SJohnston95/ece411-practicum-1/eagle/411_Layout.PNG

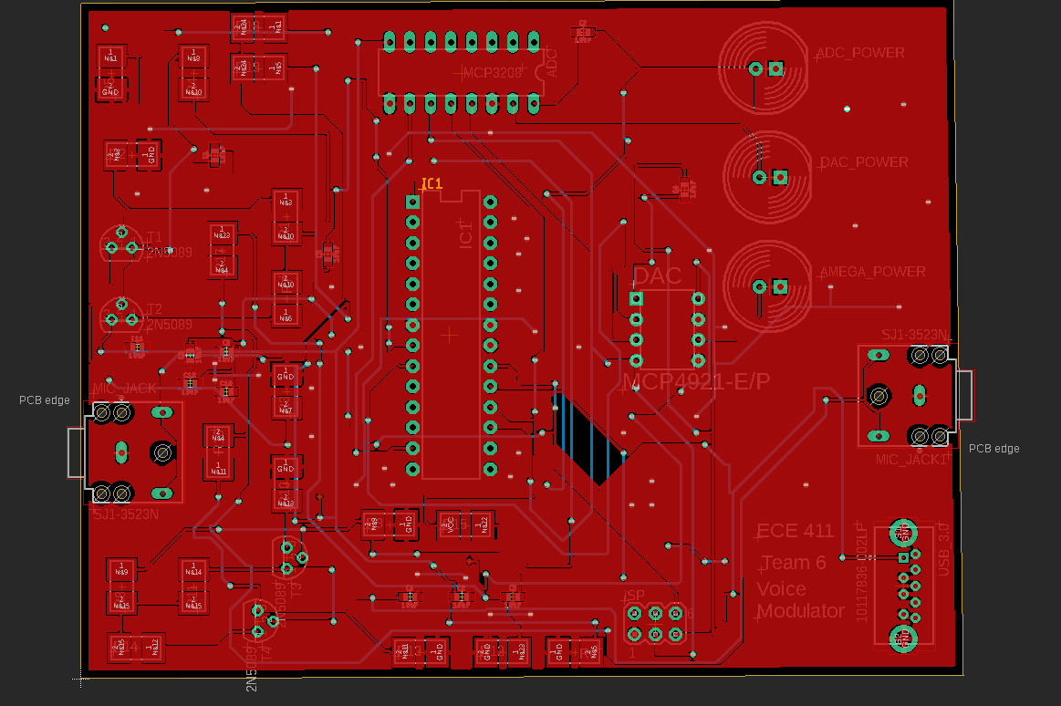
eagle/411_Layout.PNG
