SJohnston95/ece411-practicum-1/eagle/voicemodulator.PNG

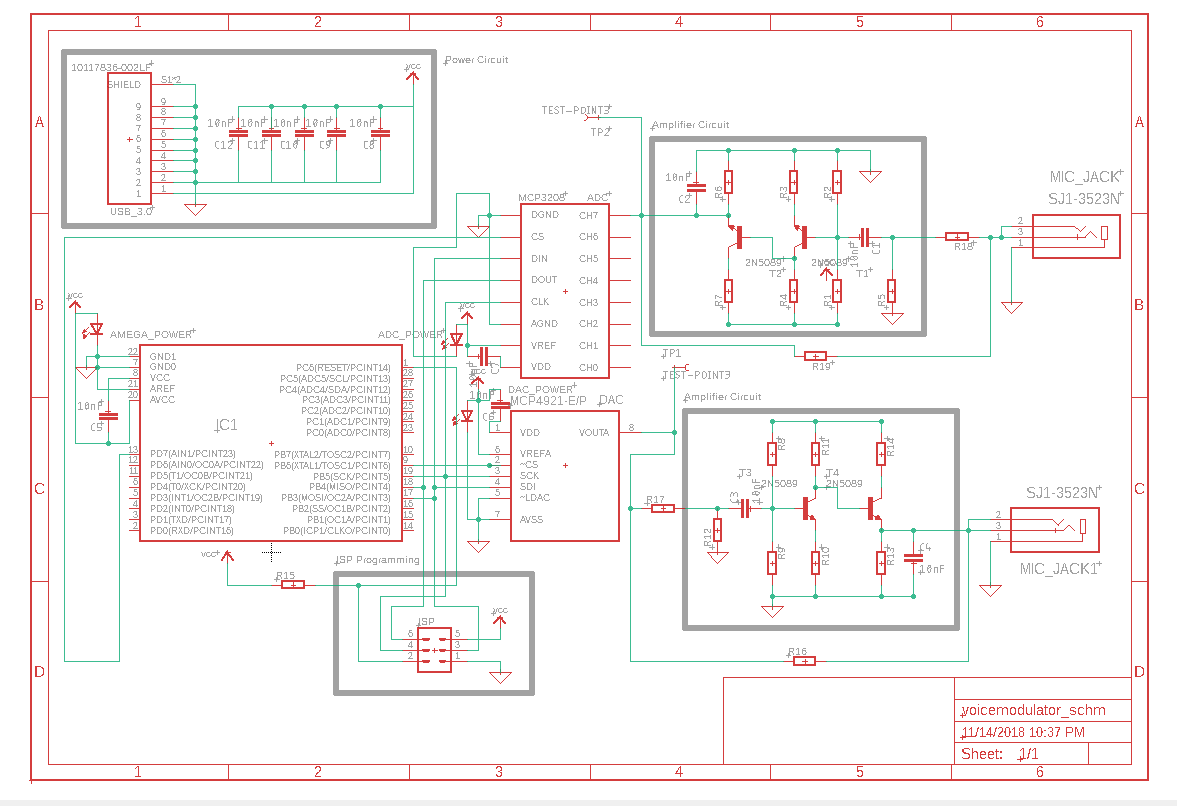
eagle/voicemodulator.PNG
