SJohnston95/ece411-practicum-1/waveforms/ECE411_bigendianbus.png

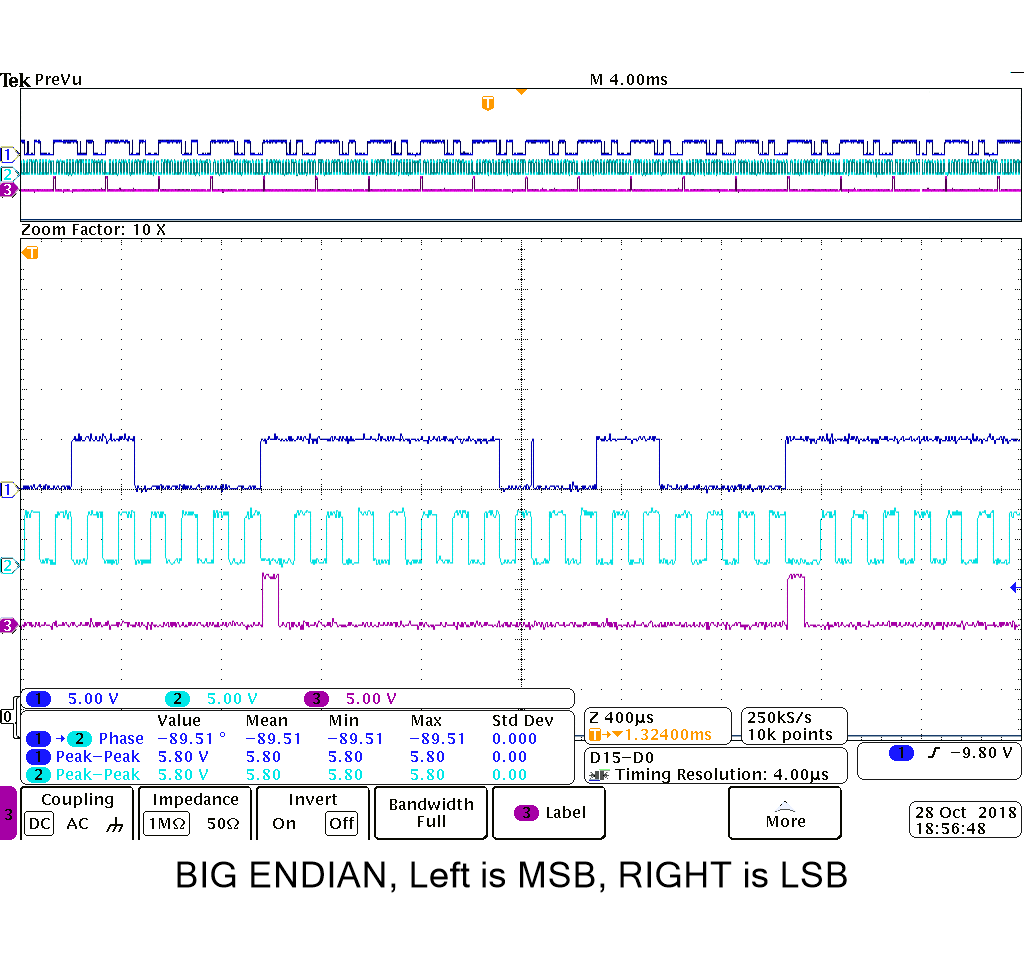
waveforms/ECE411_bigendianbus.png
