SJohnston95/ece411-practicum-1/waveforms/ECE411_littleendianbus.png

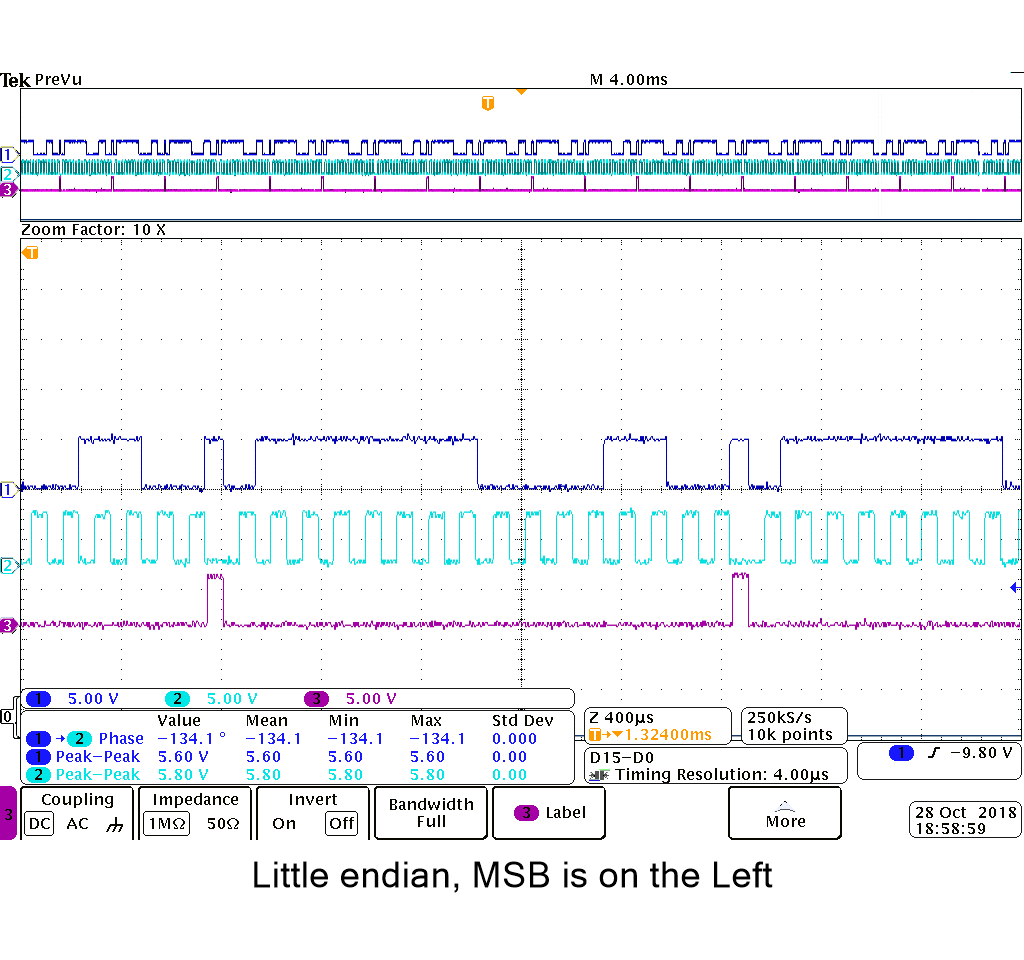
waveforms/ECE411_littleendianbus.png
