SJohnston95/ece411-practicum-1/waveforms/WorkingDAC_BUS.png

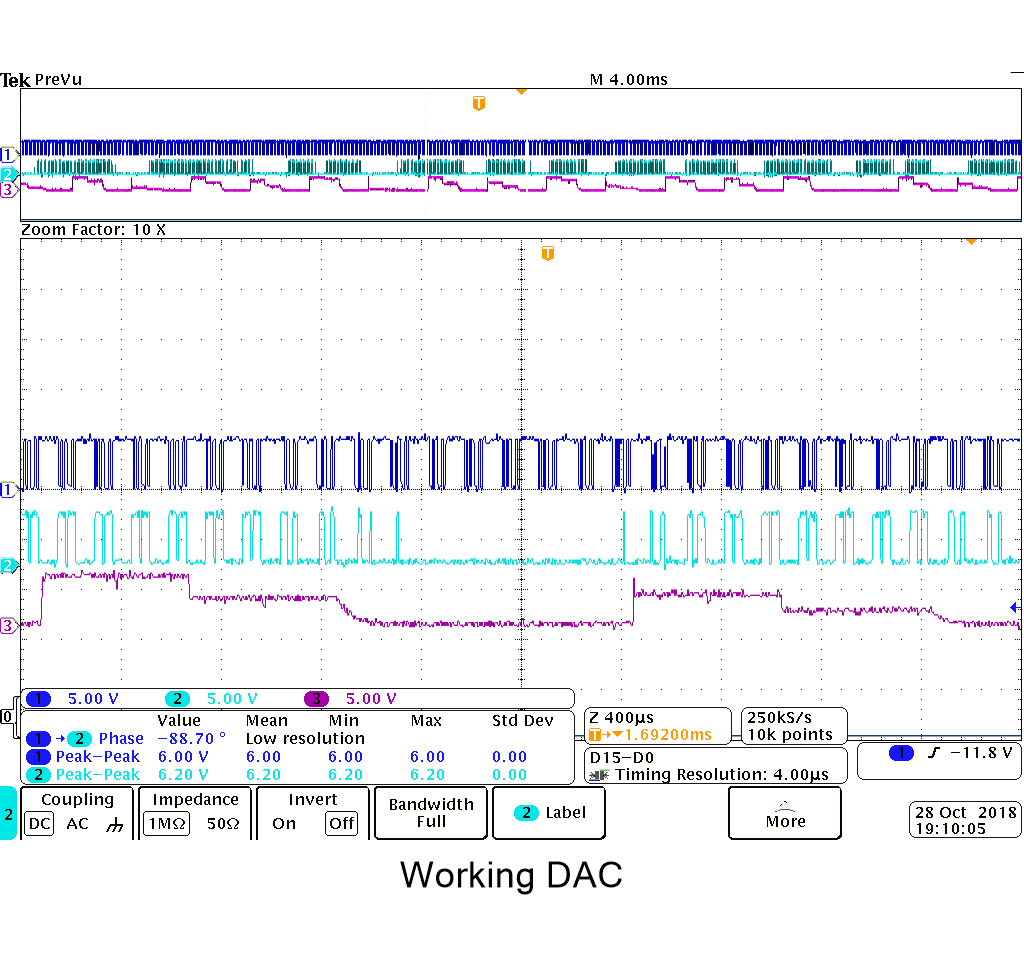
waveforms/WorkingDAC_BUS.png
