SJohnston95/ece411-practicum-1/docs/Bill of Materials.xlsx

Qty | Value | Device | Package | Parts | Description | AVAILABILITY | DESCRIPTION | MANUFACTURER | MF | MP | MPN | OC_FARNELL | OC_NEWARK | PACKAGE | PARTREV | PRICE | PROD_ID | STANDARD | SUPPLIER | VALUE
1 |  | ATMEGA48/88/168/328-PU(DIP28)PU | DIL28 | IC1
3 |  | LED10MM | LED10MM | LED1, LED2, LED3 | LED
1 |  | MA03-2 | MA03-2 | ISP | PIN HEADER |  |  |  |  |  |  | unknown | unknown
19 |  | SMR-WAV | SMS-WAV | R1, R2, R3, R4, R5, R6, R7, R8, R9, R10, R11, R12, R13, R14, R15, R16, R17, R18, R19 | SMD SHUNT RESISTOR |  |  |  |  |  |  | unknown | unknown
1 | 10117836-002LF | 10117836-002LF | AMPHENOL_10117836-002LF | USB_3.0 | Usb, 3.0 Type A, Receptacle, SMT | Unavailable | Usb, 3.0 Type A, Receptacle, SMT |  | Amphenol FCI | 10117836-002LF |  |  |  | None |  | None
4 | 10nF | 10NF-0603-50V-10% | 603 | C1, C2, C3, C4 | 0.01uF/10nF/10,000pF ceramic capacitors |  |  |  |  |  |  |  |  |  |  |  | CAP-00867 |  |  | 10nF
4 | 2N5089 | 2N5089 | TO92 | T1, T2, T3, T4 | NPN TRANSISTOR
1 | MCP3208 | MCP3208 | DIL16 | ADC |  |  |  |  |  |  |  |  |  |  |  |  |  |  |  | MCP3208
1 | MCP4921-E/P | MCP4921-E/P | DIP254P762X432-8 | DAC | DAC |  |  |  |  |  | MCP4921-E/P | 1332112 | 08J8743 | DIP-8 |  |  |  |  | Microchip
2 | SJ1-3523N | SJ1-3523N | CUI_SJ1-3523N | MIC_JACK, MIC_JACK1 | 3.5 mm Right-Angle Stereo Jack, 3 Pin PCB Mount, Non-Threaded |  |  | CUI |  |  |  |  |  |  | 1.02 |  |  | Manufacturer recommendation
2 | TEST-POINT3 | TEST-POINT3 | PAD.03X.03 | TP1, TP2 | SparkFun Test Points
