SJohnston95/ece411-practicum-1/docs/Matrix, Block Diagram.pdf

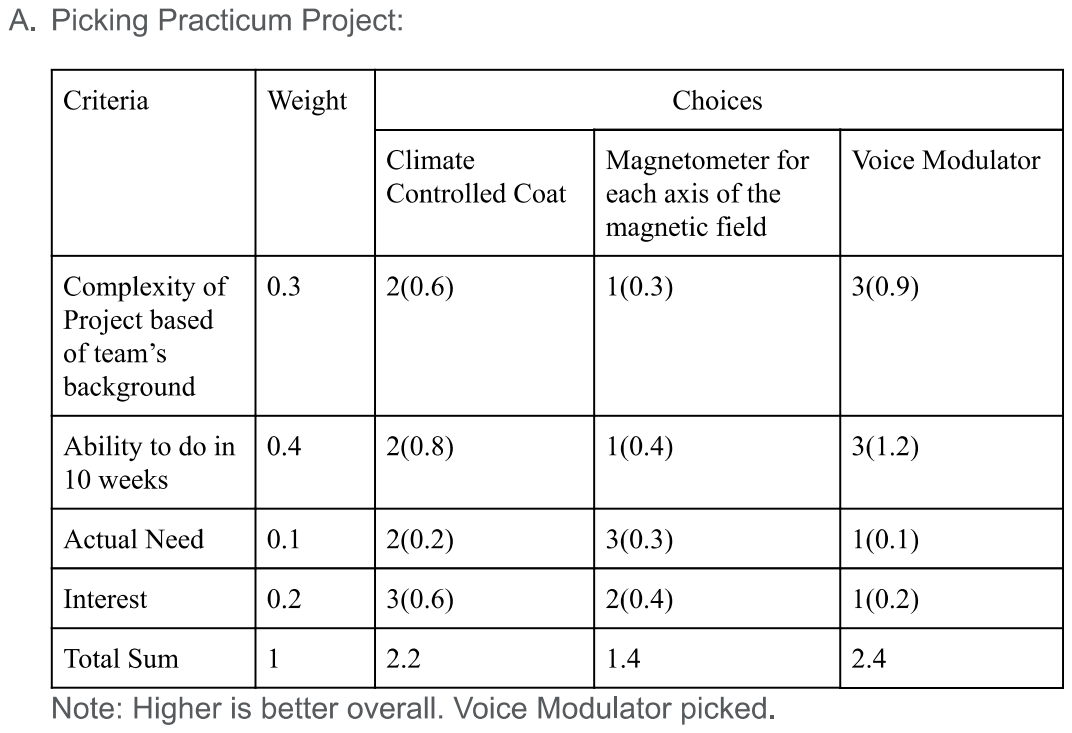
[picture p10: page 1]

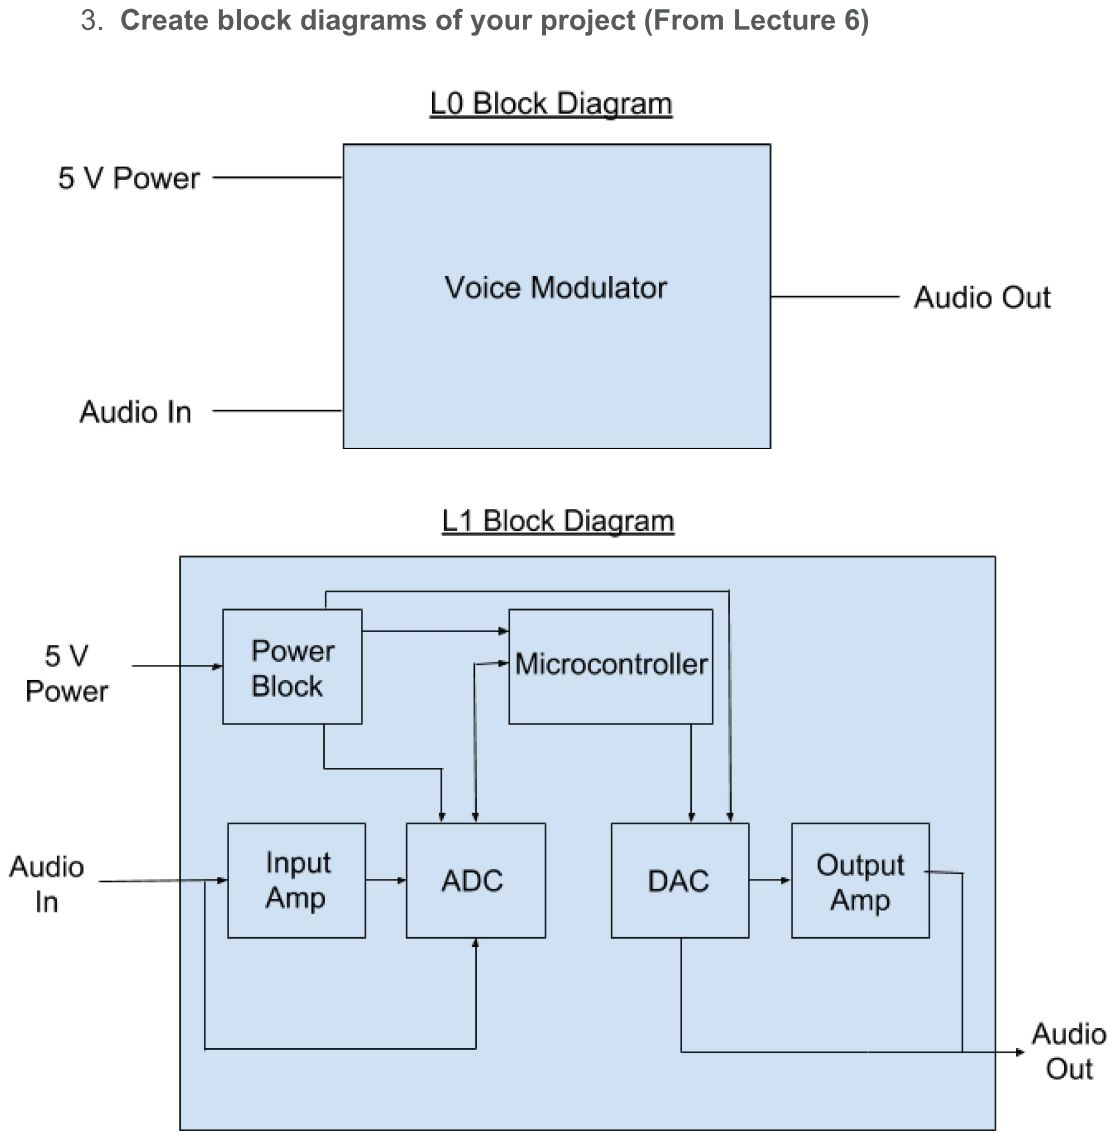
[picture p11: page 2]
