SJohnston95/ece411-practicum-1/sim/amplifier_circuit_output.asc

C1: cap; 1000µ
C2: cap; 1µ
Q1: npn; 2N3904
R1: res; 2500
R2: res; 4k
R3: res; 50
R4: res; 5
V1: voltage; 5
V2: voltage; SINE(0 1 1000)
Named nets: 0, Vout
.tran 0 100m 10m
