SJohnston95/ece411-practicum-1/sim/amplifier_circuit_input.asc

C1: cap; 100µ
C2: cap; 1µ
C3: cap; 100µ
C4: cap; 1µ
Q1: npn; 2N3904
Q2: npn; 2N3904
R1: res; 100
R2: res; 2.5k
R3: res; 6000
R4: res; 500
R5: res; 500
R6: res; 1000
R7: res; 10k
R8: res; 10000
V1: voltage; SINE(0 100u 40k)
V2: voltage; 5
V3: voltage; SINE(0 200u .5k)
Named nets: 0, Vin, Vout
.tran 0 100m 10m
