SJohnston95/ece411-practicum-1/eagle/voicemodulator_schm.brd

## EAGLE design eagle/voicemodulator_schm.brd (2018-11-15)

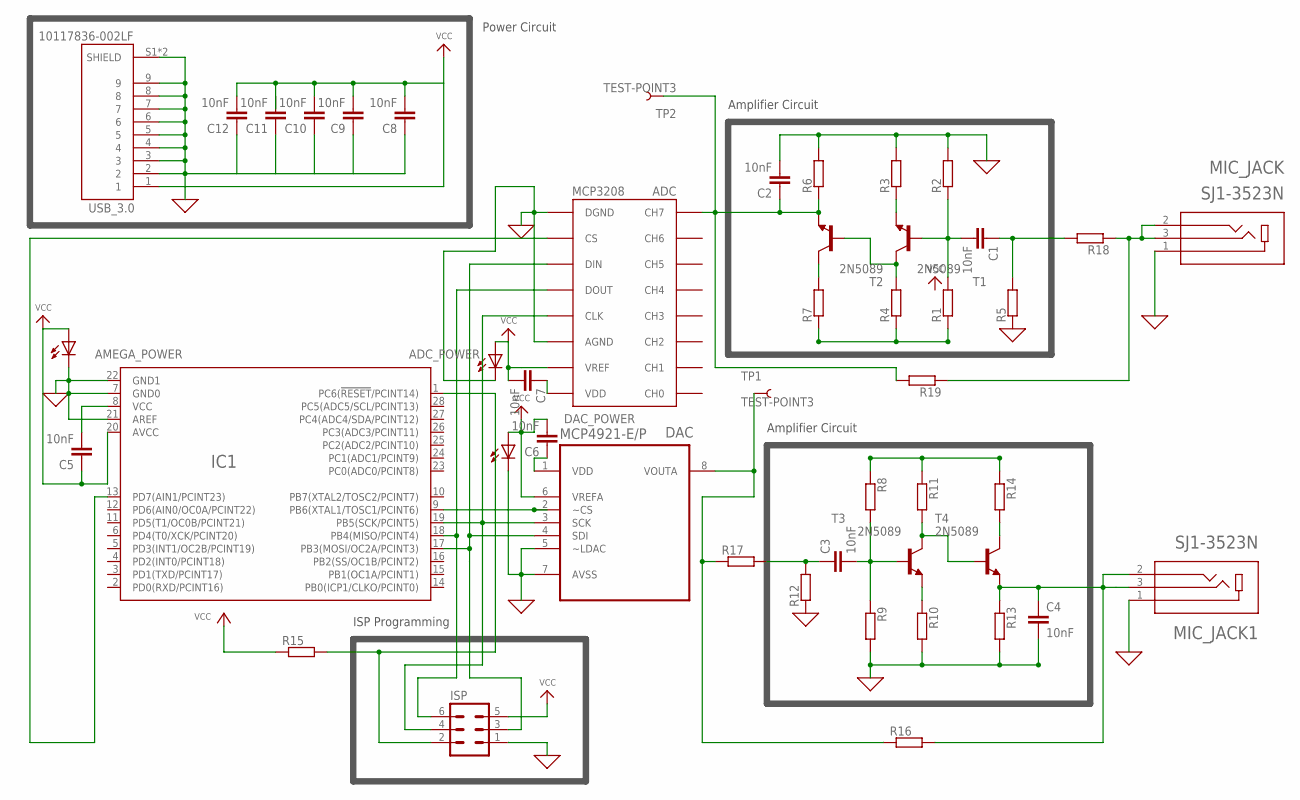
[picture p12: schematic voicemodulator_schm.sch]

Parts:
ADC: MCP3208; DIL16
ADC_POWER: LED10MM
AMEGA_POWER: LED10MM
C1, C2, C3, C4, C5, C6, C7, C8, C9, C10, C11, C12: 10nF; 0603
DAC: MCP4921-E/P; DIP254P762X432-8
DAC_POWER: LED10MM
IC1: ATMEGA48/88/168/328-PU(DIP28)PU; DIL28
ISP: MA03-2
MIC_JACK, MIC_JACK1: SJ1-3523N; CUI_SJ1-3523N
R1, R2, R3, R4, R5, R6, R7, R8, R9, R10, R11, R12, R13, R14, R15, R16, R17, R18, R19: SMR-WAV; SMS-WAV
T1, T2, T3, T4: 2N5089; TO92
TP1, TP2: TEST-POINT3; PAD.03X.03
USB_3.0: 10117836-002LF; AMPHENOL_10117836-002LF

Connections:
GND: ADC.AGND, ADC.DGND, ADC_POWER.K (C), AMEGA_POWER.K (C), C2.2, C4.2, C8.1, C9.1, C10.1, C11.1, C12.1, DAC.5 (~LDAC), DAC.7 (AVSS), DAC_POWER.K (C), IC1.7 (GND0), IC1.21 (AREF), IC1.22 (GND1), ISP.1, MIC_JACK.1, MIC_JACK1.1, R2.1, R3.1, R5.2, R6.1, R9.1, R10.1, R12.2, R13.1, USB_3.0.2, USB_3.0.3, USB_3.0.4, USB_3.0.5, USB_3.0.6, USB_3.0.7, USB_3.0.8, USB_3.0.9, USB_3.0.S1 (SHIELD), USB_3.0.S2 (SHIELD)
unnamed: C1.1, R5.1, R18.1
unnamed: ADC.DOUT, IC1.18 (PB4(MISO/PCINT4)), ISP.6
unnamed: C1.2, R1.1, R2.2, T1.2 (B)
unnamed: DAC.8 (VOUTA), R16.2, R17.2, TP1.P$1
unnamed: ADC.CH7, C2.1, R6.2, R19.1, T2.3 (E), TP2.P$1
unnamed: R7.1, T2.1 (C)
unnamed: R3.2, T1.3 (E)
unnamed: R4.1, T1.1 (C), T2.2 (B)
unnamed: C3.2, R8.1, R9.2, T3.2 (B)
unnamed: R1.2, R4.2, R7.2
unnamed: C4.1, MIC_JACK1.2, MIC_JACK1.3, R13.2, R16.1, T4.3 (E)
unnamed: R14.1, T4.1 (C)
unnamed: R10.2, T3.3 (E)
unnamed: R11.1, T3.1 (C), T4.2 (B)
unnamed: R8.2, R11.2, R14.2
unnamed: ADC.DIN, DAC.4 (SDI), IC1.17 (PB3(MOSI/OC2A/PCINT3)), ISP.3
unnamed: ADC.CLK, DAC.3 (SCK), IC1.19 (PB5(SCK/PCINT5)), ISP.4
unnamed: C6.1, DAC.1 (VDD)
unnamed: ADC.CS, IC1.13 (PD7(AIN1/PCINT23))
unnamed: DAC.2 (~CS), IC1.9 (PB6(XTAL1/TOSC1/PCINT6))
unnamed: ADC.VDD, C7.1
unnamed: IC1.1 (PC6(!RESET!/PCINT14)), ISP.2, R15.1
unnamed: C3.1, R12.1, R17.1
unnamed: MIC_JACK.2, MIC_JACK.3, R18.2, R19.2
unnamed: C5.2, IC1.8 (VCC)
VCC: ADC.VREF, ADC_POWER.A, AMEGA_POWER.A, C5.1, C6.2, C7.2, C8.2, C9.2, C10.2, C12.2, DAC.6 (VREFA), DAC_POWER.A, IC1.20 (AVCC), ISP.5, R15.2, USB_3.0.1

Notes on the sheet:
Amplifier Circuit
ISP Programming
Power Circuit

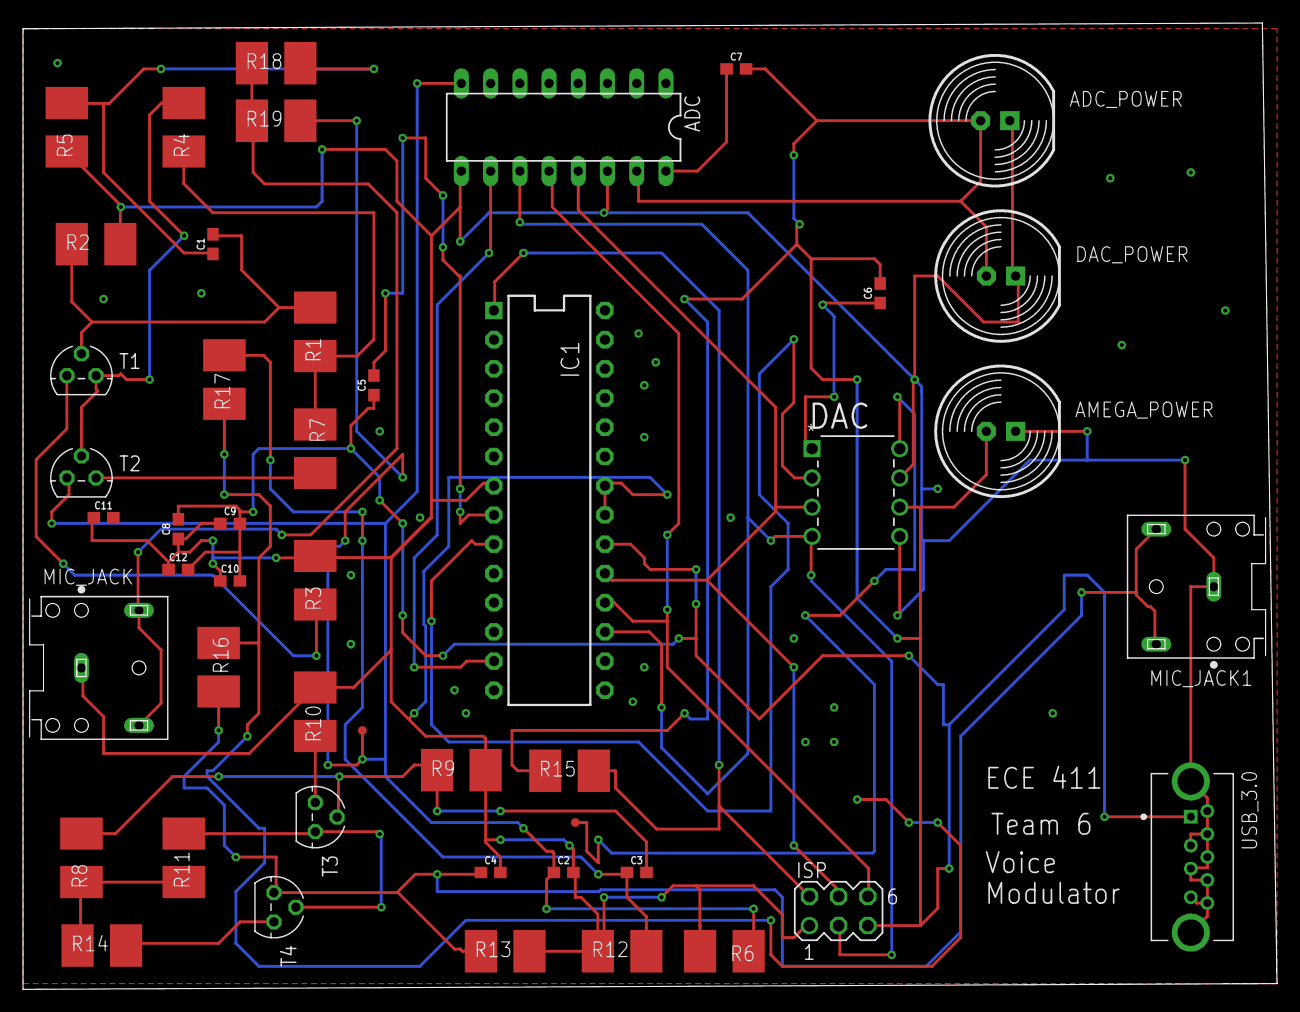
[picture p13: board voicemodulator_schm.brd from above]

Board: 2 copper layers, 109.0 x 84.0 mm, 47 parts (0 on the bottom side), 27 nets.
