SJohnston95/ece411-practicum-1/src/voice-modulator/voice-modulator/main.cpp

/*
 * voice-modulator.cpp
 *
 * Created: 10/28/2018 1:10:05 PM
 * Author : parola
 */ 

#include <avr/io.h>


int main(void)
{
    /* Replace with your application code */
    while (1) 
    {
    }
}
