SJohnston95/ece411-practicum-1/(commit log)

2018-10-14 I added the AVR pin programming document
2018-10-14 Bill of Materials
    Initial Upload- updated w/ price per, quantity and resource links.
    [Bill of Materials.xlsx]
2018-10-18 Working main file for the led to flash on and off.
2018-10-21 Main2.0
    Here's the main we are using to communicate with the DAC. We're getting the data from the ADC, storing it and trying to move it to the DAC. This is not working code yet, and we are still learning. "Please forgive any typos"
    [main.cpp]
2018-10-22 Main 2.2
    Here's a copy of the most up to date Main file. I found a different way to use SPI by using distinct predefined registers. I still cannot get it to work however. I'm not sure why. The 'Data2 = 10101001" declaration is a result of my attempt to bypass sensorvalue all together and to merely have as many easily detectable rising and falling triggers as possible.
2018-10-25 Add preliminary schematic
    [voicemodulator_schm.sch]
2018-10-25 Add ISP pin to schematic
    [voicemodulator_schm.sch]
2018-10-25 Main 3.0
    Here's a copy of my main file with SPI working correctly. I haven't been able to get this SPI to interface with the dac correctly just yet.
2018-10-28 BOM run from schematic
    May need additional details added such as resources and prices.
2018-10-28 BOM from Schematic
    May want to add additional details such as price, price per, resources and such.
    [Bill of Materials.xlsx]
2018-10-28 Libraries used for EAGLE Schematic Design
2018-10-28 Libraries used from schematic design
2018-10-28 Imported an Arduino library
    As a test
2018-10-28 Tested Arduino sketch import capability
2018-10-29 Update schematic and rename folder
    Folder has been renamed to "eagle" so that it's easier to find.
    Schematic and PNG has been updated to a version that has no ERC errors.
    Resistors and capacitor values still need to be assigned.
    [voicemodulator_schm.sch]
2018-10-29 Add library with fixed pars for project
    Added a fixed version of ATmega48 DIP package. Also includes ADC, DAC,
    and the specific Mic jack we'll be using.
2018-11-02 Board Layout from 10/31
    [voicemodulator_schm.brd]
2018-11-04 input and output circuits
    Here's my simulations of the input/output circuits I designed
2018-11-04 Pullup resistor added, testpoints at ADC in and DAC out added.
    Pictures, board layout and schematic all updated.
    [voicemodulator_schm.brd, voicemodulator_schm.sch]
2018-11-04 Found SPI ADC example
    http://extremeelectronics.co.in/avr-tutorials/interfacing-12-bit-spi-adc-mcp3204-with-avr-micro/
2018-11-08 Add Arduino sketch that reads in audio signal
2018-11-11 Added 10 mm Power LEDs
    [voicemodulator_schm.brd, voicemodulator_schm.sch]
2018-11-11 Added output mic jack.
    [voicemodulator_schm.brd, voicemodulator_schm.sch]
2018-11-12 Fix incorrect dimensions in eagle library for DIP
    48A DIP device dimensions on layout were incorrect and needed modifying
    to match what is specified in the datasheet.
    [voicemodulator_schm.brd, voicemodulator_schm.sch]
2018-11-12 Segmented output into two paths with 0 ohm resistors
    [voicemodulator_schm.brd, voicemodulator_schm.sch]
2018-11-12 Updated with new model that is adjusted to correct Atmega48A dimensions.
    [voicemodulator_schm.brd, voicemodulator_schm.sch]
2018-11-12 Segmented input with 0 ohm resistors for w/ amp vs. not
    [voicemodulator_schm.brd, voicemodulator_schm.sch]
2018-11-13 USB 3.0 Type A Port Added, pinout TBD
    [voicemodulator_schm.brd, voicemodulator_schm.sch]
2018-11-14 Made USB 3.0 connections
    [voicemodulator_schm.brd, voicemodulator_schm.sch]
2018-11-14 BOM updated since USB 3 added
    [Bill of Materials.xlsx]
2018-11-14 Add new attempt to read and output ADC0
    Includes more detailed commenting of previous code that implements SPI
    with DAC
2018-11-15 Added name of LEDs and labeling for group/project on silk screen layer
    [voicemodulator_schm.brd, voicemodulator_schm.sch]
2018-11-15 Attempt 2 with silkscreen layer additions
2018-11-15 Attempt 2 to commit silkscreen changes
2018-11-15 Grounded LEDs on power pins, added bypass caps at power pins
    [voicemodulator_schm.brd, voicemodulator_schm.sch]
2018-11-15 Fixed erc error I missed on DAC
    [voicemodulator_schm.brd, voicemodulator_schm.sch]
2018-11-15 Updated trace width to 0.254
    [voicemodulator_schm.brd]
2018-11-15 Add caps for input voltage coming in through USB 3.0, remaining wire widths resolved.
    [voicemodulator_schm.brd, voicemodulator_schm.sch]
2018-11-15 Ground plane and multiple vias added for flooded ground
    [voicemodulator_schm.brd]
2018-11-15 Main 4.1
    Here's my code for 4.1, there's very little changes from 4.0 to 4.1. Just some code cleanup on the ADC program, it still doesn't work.
2018-11-19 Main 6.0
    This is main 6.0. It has a working ADC and working DAC. The only thing that is required is voltage amplification on the input and current amplification on the output.
2018-11-25 added mcp3208 arduino code
2018-11-28 DAC library that we've tested
    Minor edits that caused problems in the original header. Original
    forgot to include SPI. Link to original library is below.
    https://github.com/michd/Arduino-MCP492X
2018-11-28 Successful test code that works with Arduino Nano
    Uses new DAC library. Tested and works.
2018-11-28 Made cleaned up version of main6.cpp in src/passthroughTest
    Made a new project folder with a cleaned up version of main6.cpp, which I believe is the most recent version of the non-arduino code we had working.
    Also contains a project status text file.
    Code should be functionally identical, just easier to read and work with, still needs a lot of work.
2018-11-28 Test plans done
    [test_charts.xlsx]
2018-11-29 Added Gantt Chart, closes #17
    [Gantt chart.xlsx]
2018-12-01 Started ADC DAC integration test
    Copied working DAC code to new folder to start integrating the ADC in, included new ADC library.
    [doxygen.cfg]
2018-12-02 Cleanup and new arduino_passthrough_test folder.
    Did some cleanup of old files and started a new project folder, ADC library I was testing didn't work out.
    [doxygen.cfg]
2018-12-02 Cleanup docs
    [Bill of Materials.xlsx, Gantt chart.xlsx]
2018-12-03 Got acd_dac "working".
    Not totally working, but we now have a passthrough of a sort.
    [doxygen.cfg]
2018-12-03 Passthrough working
    fixes #13
    [adc_dac.ino, testdac.ino]
2018-12-05 Updated Gantt Chart to be current by presentation
    [Gantt chart.xlsx]
2018-12-05 Updated Gantt Chart for presentation
    [Gantt chart.xlsx]
2018-12-05 Updated Readme for uploading to board. Also made everything work(ish).
